FabianH2301/Studienarbeit/Platine/Studienarbeit.kicad_pcb

## KiCad design Platine/Studienarbeit.kicad_pcb (2020-02-13)

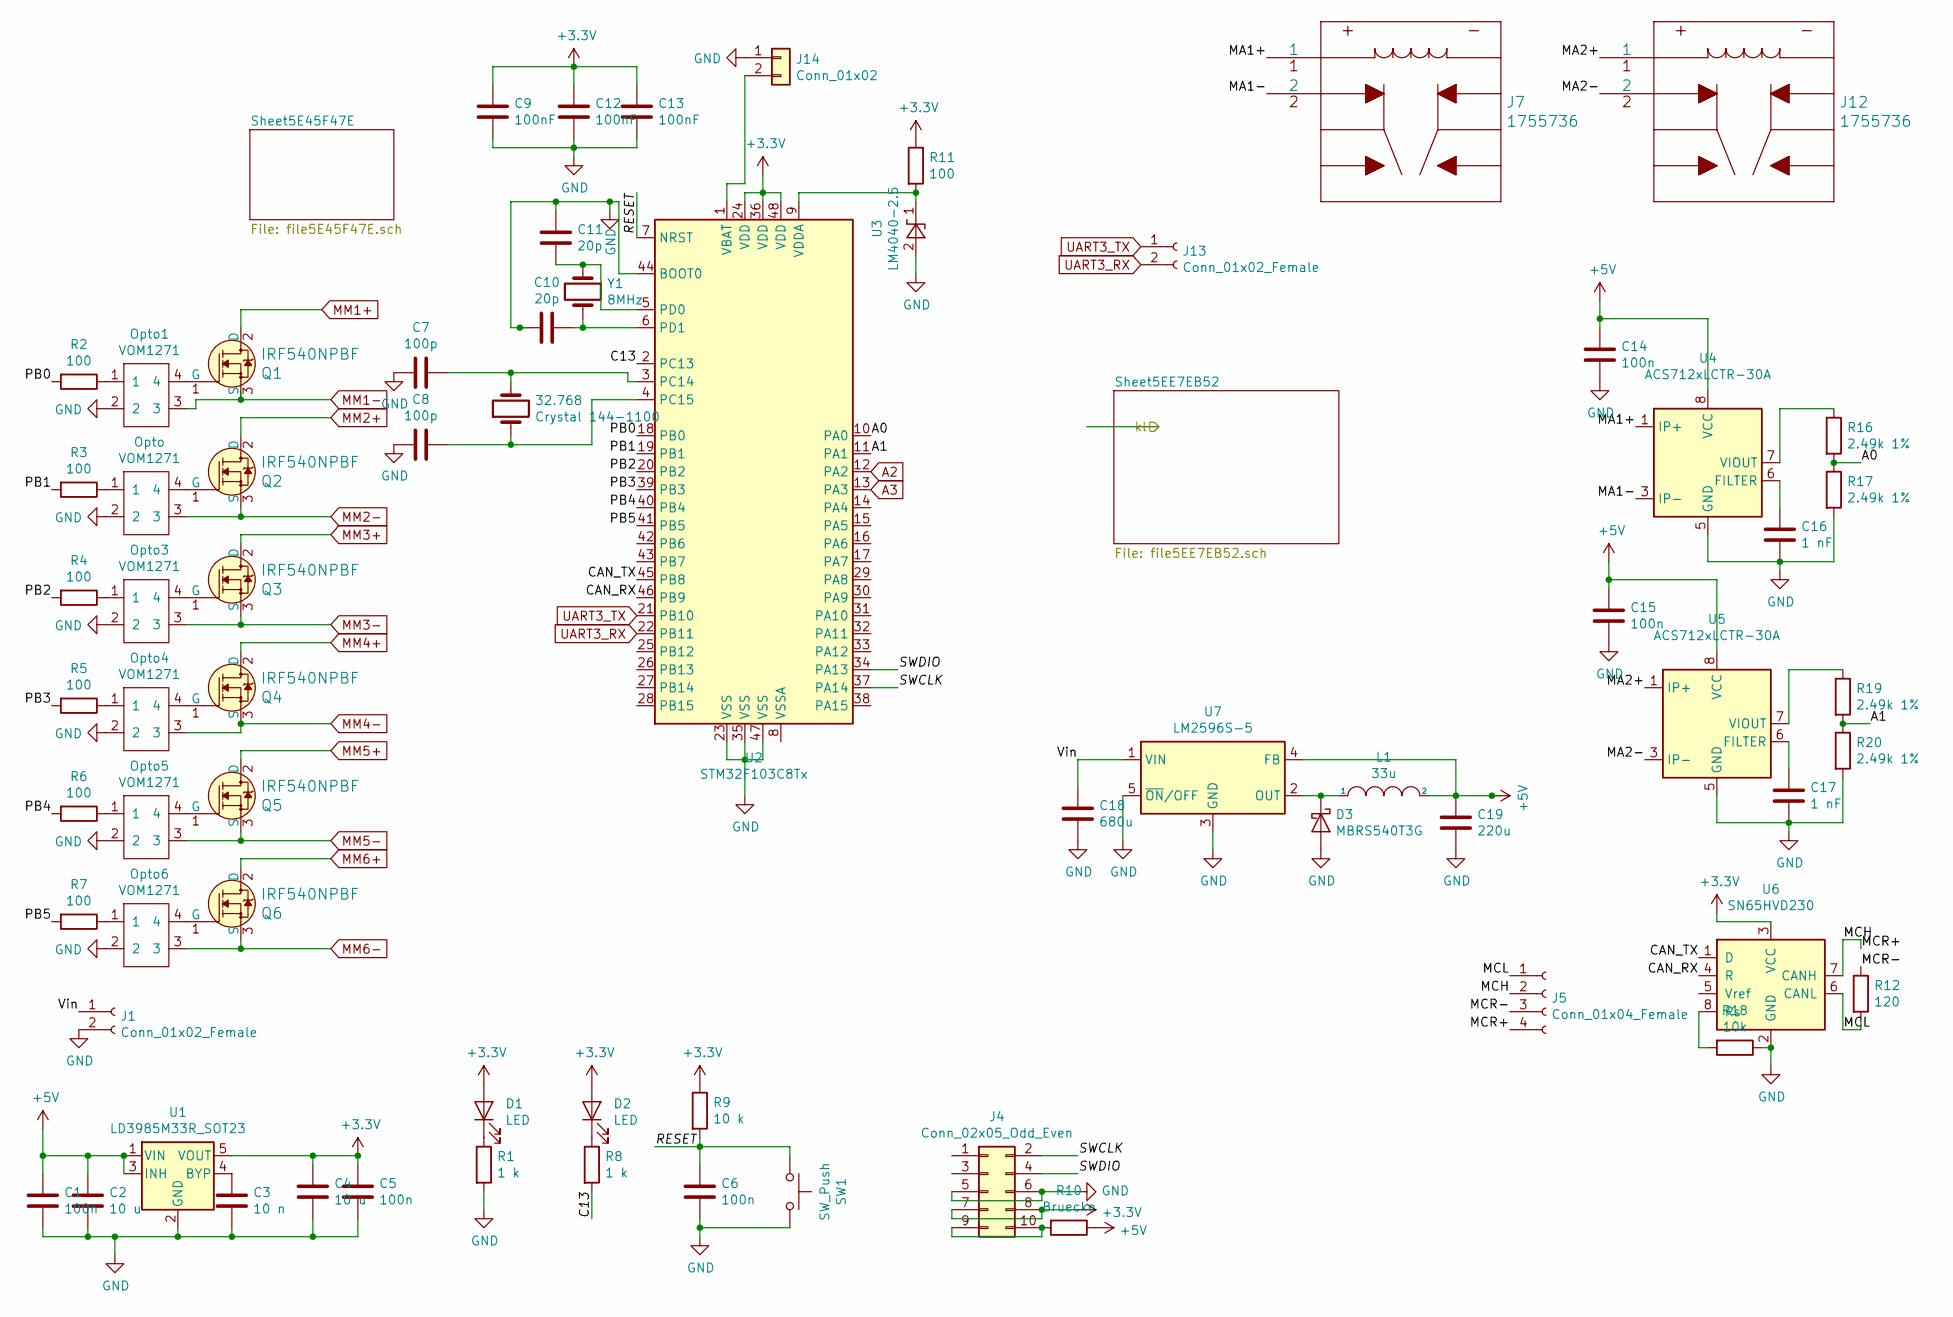
[picture p1: schematic Studienarbeit.sch]

Parts:
32.768: Crystal 144-1100; Crystal_SMD_2520-4Pin_2.5x2.0mm
C1, C5, C14, C15: 100n; C_0805_2012Metric; LCSC C136621
C2, C4: 10 u; C_0805_2012Metric; LCSC C15850
C3: 10 n; C_0805_2012Metric
C6: 100n; C_0805_2012Metric
C7, C8: 100p; C_0805_2012Metric
C9, C12, C13: 100nF; C_0805_2012Metric; LCSC C136621
C10, C11: 20p; C_0805_2012Metric
C16, C17: 1 nF; C_0805_2012Metric
C18: 680u; C_Elec_10x10.2
C19: 220u; C_Elec_8x6.2
D1, D2: LED; LED_0603_1608Metric; LCSC C2286
D3: MBRS540T3G; D_SMC; LCSC C31849
J1, J13: Conn_01x02_Female; JST_XH_B2B-XH-A_1x02_P2.50mm_Vertical
J4: Conn_02x05_Odd_Even; PinHeader_2x05_P2.54mm_Vertical
J5: Conn_01x04_Female; JST_XH_B4B-XH-A_1x04_P2.50mm_Vertical
J7, J12: 1755736; PhoenixContact1755736
J14: Conn_01x02; PinHeader_1x02_P2.54mm_Vertical
L1: 33u; L_Wuerth_WE-PD-Typ-LS
Opto, Opto1, Opto3, Opto4, Opto5, Opto6: VOM1271; LCSC C146286
Q1, Q2, Q3, Q4, Q5, Q6: IRF540NPBF; TO-220-3_Vertical; MPN IRF540NPBF; Digi-Key_PN IRF540NPBF-ND
R1, R8: 1 k; R_0805_2012Metric; LCSC C17513
R2: 100; R_0805_2012Metric
R3, R4, R5, R6, R7, R11: 100; R_0805_2012Metric; LCSC C17408
R9: 10 k; R_0805_2012Metric; LCSC C17414
R10: Bruecke; R_0805_2012Metric
R12: 120; R_0805_2012Metric; LCSC C17437
R16, R17, R19, R20: 2.49k 1%; R_0805_2012Metric; LCSC C17408
R18: 10k; R_0805_2012Metric; LCSC C17414
SW1: SW_Push; SW_SPST_B3S-1000
U1: LD3985M33R_SOT23; SOT-23-5; LCSC C46243
U2: STM32F103C8Tx; LQFP-48_7x7mm_P0.5mm; LCSC C8734
U3: LM4040-2.5; SOT-23
U4, U5: ACS712xLCTR-30A; SOIC-8_3.9x4.9mm_P1.27mm; LCSC C9932
U6: SN65HVD230; SOIC-8_3.9x4.9mm_P1.27mm; LCSC C12084
U7: LM2596S-5; TO-263-5_TabPin3; LCSC C10002
Y1: 8MHz; Crystal_HC49-4H_Vertical

Connections:
+3V3: C4.1, C5.1, C9.1, C12.1, C13.1, D1.2 (A), D2.2 (A), J4.7, J4.8, R9.1, R11.1, U1.5 (VOUT), U2.24 (VDD), U2.36 (VDD), U2.48 (VDD), U6.3 (VCC)
+5V: C1.1, C2.1, C14.2, C15.2, C19.1, L1.2, R10.1, U1.1 (VIN), U1.3 (INH), U4.8 (VCC), U5.8 (VCC), U7.4 (FB); also elsewhere on the board
/A0: R16.2, R17.1, U2.10 (PA0)
/A1: R19.2, R20.1, U2.11 (PA1)
/C13: R8.2, U2.2 (PC13)
/CAN_RX: U2.46 (PB9), U6.4 (R)
/CAN_TX: U2.45 (PB8), U6.1 (D)
/MA1+: J7.1, U4.1 (IP+), U4.2 (IP+)
/MA1-: J7.2, U4.3 (IP-), U4.4 (IP-)
/MA2+: J12.1, U5.1 (IP+), U5.2 (IP+)
/MA2-: J12.2, U5.3 (IP-), U5.4 (IP-)
/MCH: J5.2, J5.4, U6.7 (CANH)
/MCL: J5.1, R12.2, U6.6 (CANL)
/MCR-: J5.3, R12.1
/PB0: R2.2, U2.18 (PB0)
/PB1: R3.2, U2.19 (PB1)
/PB2: R4.2, U2.20 (PB2)
/PB3: R5.2, U2.39 (PB3)
/PB4: R6.2, U2.40 (PB4)
/PB5: R7.2, U2.41 (PB5)
/RESET: C6.1, R9.2, SW1.1, U2.7 (NRST)
/SWCLK: J4.2, U2.37 (PA14)
/SWDIO: J4.4, U2.34 (PA13)
/Vin: C18.1, J1.1, U7.1 (VIN)
A2: U2.12 (PA2); also elsewhere on the board
A3: U2.13 (PA3); also elsewhere on the board
GND: C1.2, C2.2, C3.2, C4.2, C5.2, C6.2, C7.2, C8.2, C9.2, C10.1, C11.1, C12.2, C13.2, C14.1, C15.1, C16.1, C17.1, C18.2, C19.2, D3.2 (A), J1.2, J4.5, J4.6, J14.1, Opto.2, Opto1.2, Opto3.2, Opto4.2, Opto5.2, Opto6.2, R1.2, R17.2, R18.1, R20.2, SW1.2, U1.2 (GND), U2.23 (VSS), U2.35 (VSS), U2.44 (BOOT0), U2.47 (VSS), U3.2 (A), U4.5 (GND), U5.5 (GND), U6.2 (GND), U7.3 (GND), U7.5 (~ON~/OFF); also elsewhere on the board
MM1+: Q1.2 (D); also elsewhere on the board
MM1-: Opto1.3, Q1.3 (S); also elsewhere on the board
MM2+: Q2.2 (D); also elsewhere on the board
MM2-: Opto.3, Q2.3 (S); also elsewhere on the board
MM3+: Q3.2 (D); also elsewhere on the board
MM3-: Opto3.3, Q3.3 (S); also elsewhere on the board
MM4+: Q4.2 (D); also elsewhere on the board
MM4-: Opto4.3, Q4.3 (S); also elsewhere on the board
MM5+: Q5.2 (D); also elsewhere on the board
MM5-: Opto5.3, Q5.3 (S); also elsewhere on the board
MM6+: Q6.2 (D); also elsewhere on the board
MM6-: Opto6.3, Q6.3 (S); also elsewhere on the board
unnamed: 32.768.1, C8.1, U2.4 (PC15)
unnamed: 32.768.2, C7.1, U2.3 (PC14)
unnamed: C3.1, U1.4 (BYP)
unnamed: C10.2, U2.6 (PD1), Y1.2
unnamed: C11.2, U2.5 (PD0), Y1.1
unnamed: C16.2, U4.6 (FILTER)
unnamed: C17.2, U5.6 (FILTER)
unnamed: D1.1 (K), R1.1
unnamed: D2.1 (K), R8.1
unnamed: D3.1 (K), L1.1, U7.2 (OUT)
unnamed: J4.9, J4.10, R10.2
unnamed: J14.2, U2.1 (VBAT)
unnamed: Opto1.1, R2.1
unnamed: Opto1.4, Q1.1 (G)
unnamed 72: Opto.1, R3.1; also elsewhere on the board
unnamed 73: Opto.4, Q2.1 (G); also elsewhere on the board
unnamed: Opto3.1, R4.1
unnamed: Opto3.4, Q3.1 (G)
unnamed: Opto4.1, R5.1
unnamed: Opto4.4, Q4.1 (G)
unnamed: Opto5.1, R6.1
unnamed: Opto5.4, Q5.1 (G)
unnamed: Opto6.1, R7.1
unnamed: Opto6.4, Q6.1 (G)
unnamed: R11.2, U2.9 (VDDA), U3.1 (K)
unnamed: R16.1, U4.7 (VIOUT)
unnamed: R18.2, U6.8 (Rs)
unnamed: R19.1, U5.7 (VIOUT)
UART3_RX: J13.2, U2.22 (PB11)
UART3_TX: J13.1, U2.21 (PB10)

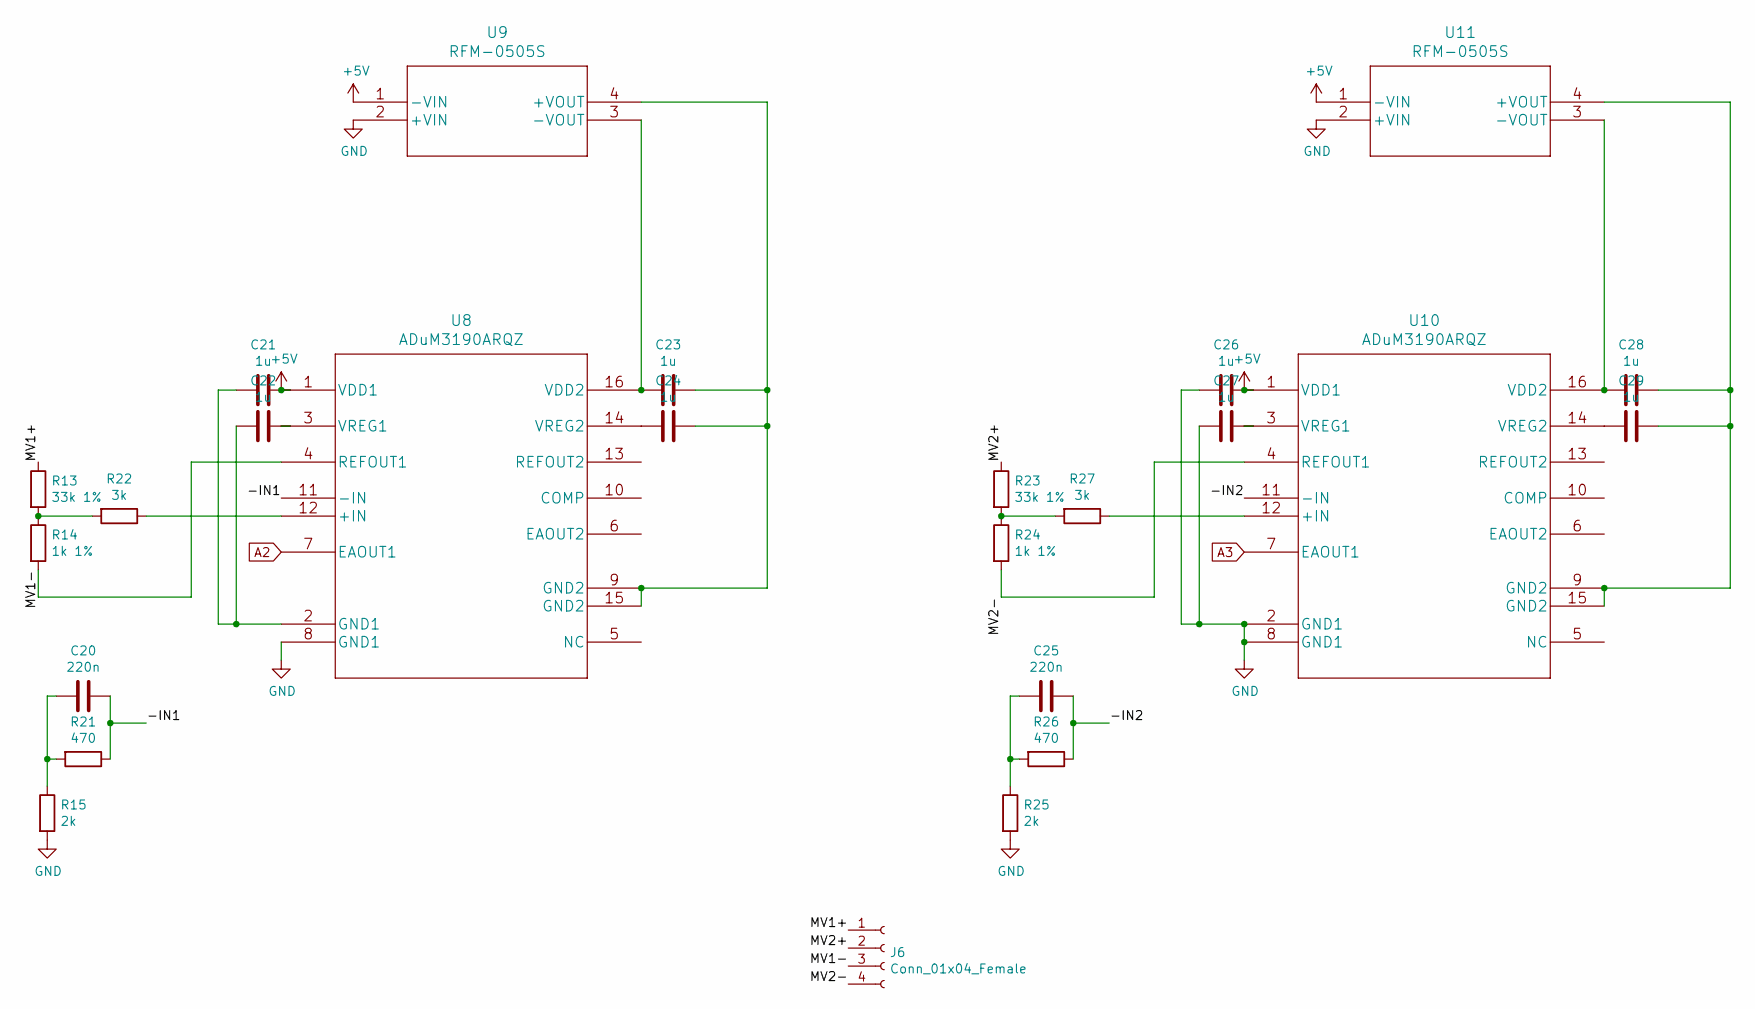
[picture p2: schematic file5EE7EB52.sch]

Parts:
C20, C25: 220n; C_0805_2012Metric; LCSC C5378
C21, C22, C23, C24, C26, C27, C28, C29: 1u; C_0805_2012Metric; LCSC C28323
J6: Conn_01x04_Female; JST_XH_B4B-XH-A_1x04_P2.50mm_Vertical
R13, R23: 33k 1%; R_0805_2012Metric; LCSC C17633
R14, R24: 1k 1%; R_0805_2012Metric; LCSC C17513
R15, R25: 2k; R_0805_2012Metric; LCSC C17604
R21, R26: 470; R_0805_2012Metric; LCSC C17710
R22, R27: 3k; R_0805_2012Metric; LCSC C17661
U8, U10: ADuM3190ARQZ
U9, U11: RFM-0505S

Connections:
+5V: C21.2, C26.2, U8.1 (VDD1), U9.1 (-VIN), U10.1 (VDD1), U11.1 (-VIN); also elsewhere on the board
/Sheet5EE7EB52/-IN1: C20.1, R21.1, U8.11 (-IN)
/Sheet5EE7EB52/-IN2: C25.1, R26.1, U10.11 (-IN)
/Sheet5EE7EB52/MV1+: J6.1, R13.1
/Sheet5EE7EB52/MV1-: J6.3, R14.2, U8.4 (REFOUT1)
/Sheet5EE7EB52/MV2+: J6.2, R23.1
/Sheet5EE7EB52/MV2-: J6.4, R24.2, U10.4 (REFOUT1)
A2: U8.7 (EAOUT1); also elsewhere on the board
A3: U10.7 (EAOUT1); also elsewhere on the board
GND: C26.1, C27.1, R15.2, R25.2, U8.8 (GND1), U9.2 (+VIN), U10.2 (GND1), U10.8 (GND1), U11.2 (+VIN); also elsewhere on the board
unnamed: C20.2, R15.1, R21.2
unnamed: C21.1, C22.1, U8.2 (GND1)
unnamed: C22.2, U8.3 (VREG1)
unnamed: C23.1, U8.16 (VDD2), U9.3 (-VOUT)
unnamed: C23.2, C24.2, U8.9 (GND2), U8.15 (GND2), U9.4 (+VOUT)
unnamed: C24.1, U8.14 (VREG2)
unnamed: C25.2, R25.1, R26.2
unnamed: C27.2, U10.3 (VREG1)
unnamed: C28.1, U10.16 (VDD2), U11.3 (-VOUT)
unnamed: C28.2, C29.2, U10.9 (GND2), U10.15 (GND2), U11.4 (+VOUT)
unnamed: C29.1, U10.14 (VREG2)
unnamed: R13.2, R14.1, R22.2
unnamed: R22.1, U8.12 (+IN)
unnamed: R23.2, R24.1, R27.2
unnamed: R27.1, U10.12 (+IN)

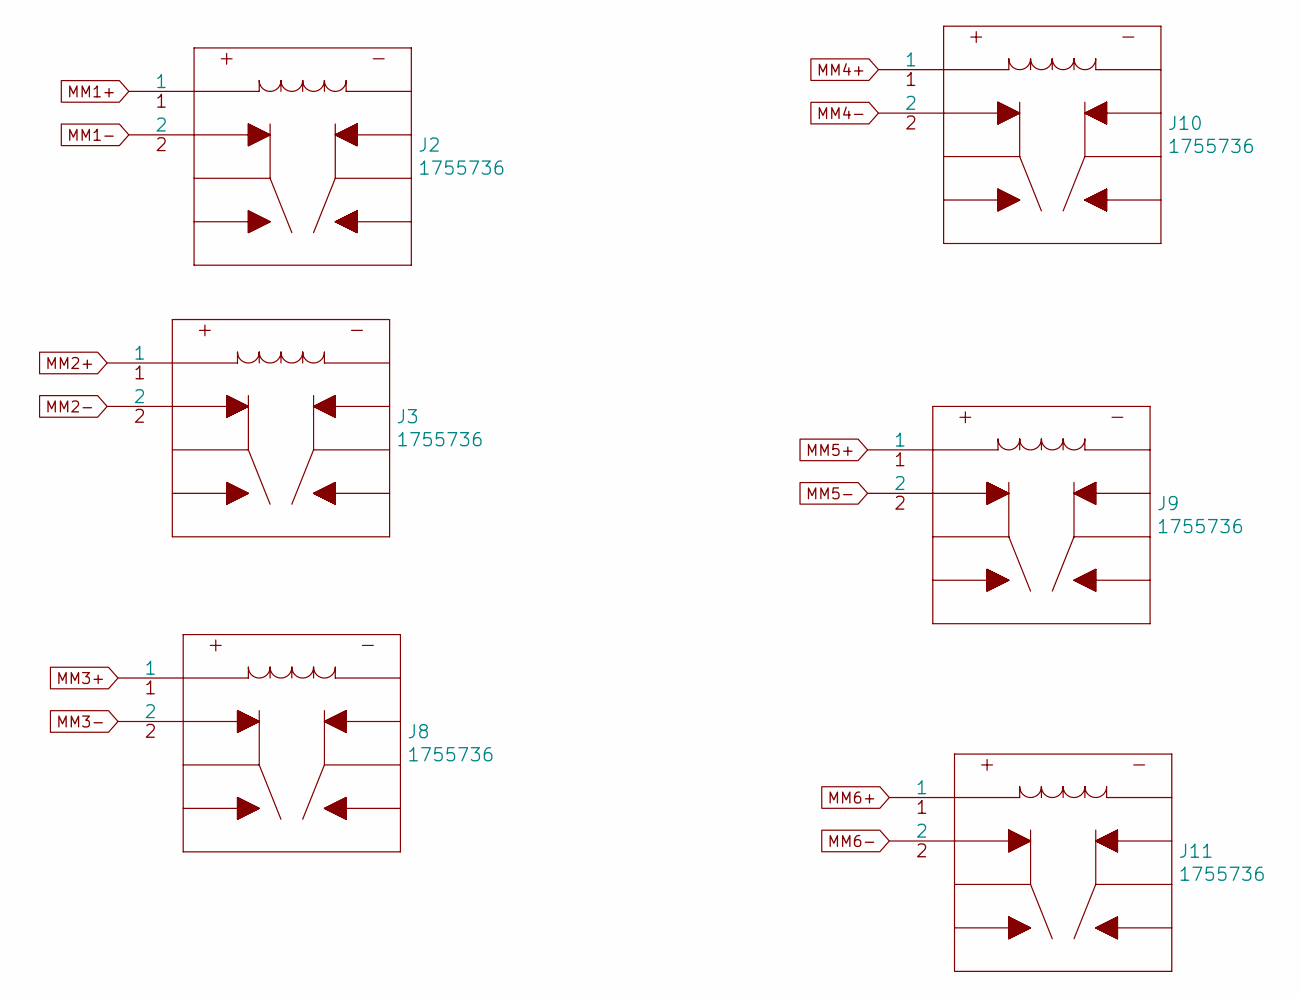
[picture p3: schematic file5E45F47E.sch]

Parts:
J2, J3, J8, J9, J10, J11: 1755736; PhoenixContact1755736

Connections:
MM1+: J2.1; also elsewhere on the board
MM1-: J2.2; also elsewhere on the board
MM2+: J3.1; also elsewhere on the board
MM2-: J3.2; also elsewhere on the board
MM3+: J8.1; also elsewhere on the board
MM3-: J8.2; also elsewhere on the board
MM4+: J10.1; also elsewhere on the board
MM4-: J10.2; also elsewhere on the board
MM5+: J9.1; also elsewhere on the board
MM5-: J9.2; also elsewhere on the board
MM6+: J11.1; also elsewhere on the board
MM6-: J11.2; also elsewhere on the board

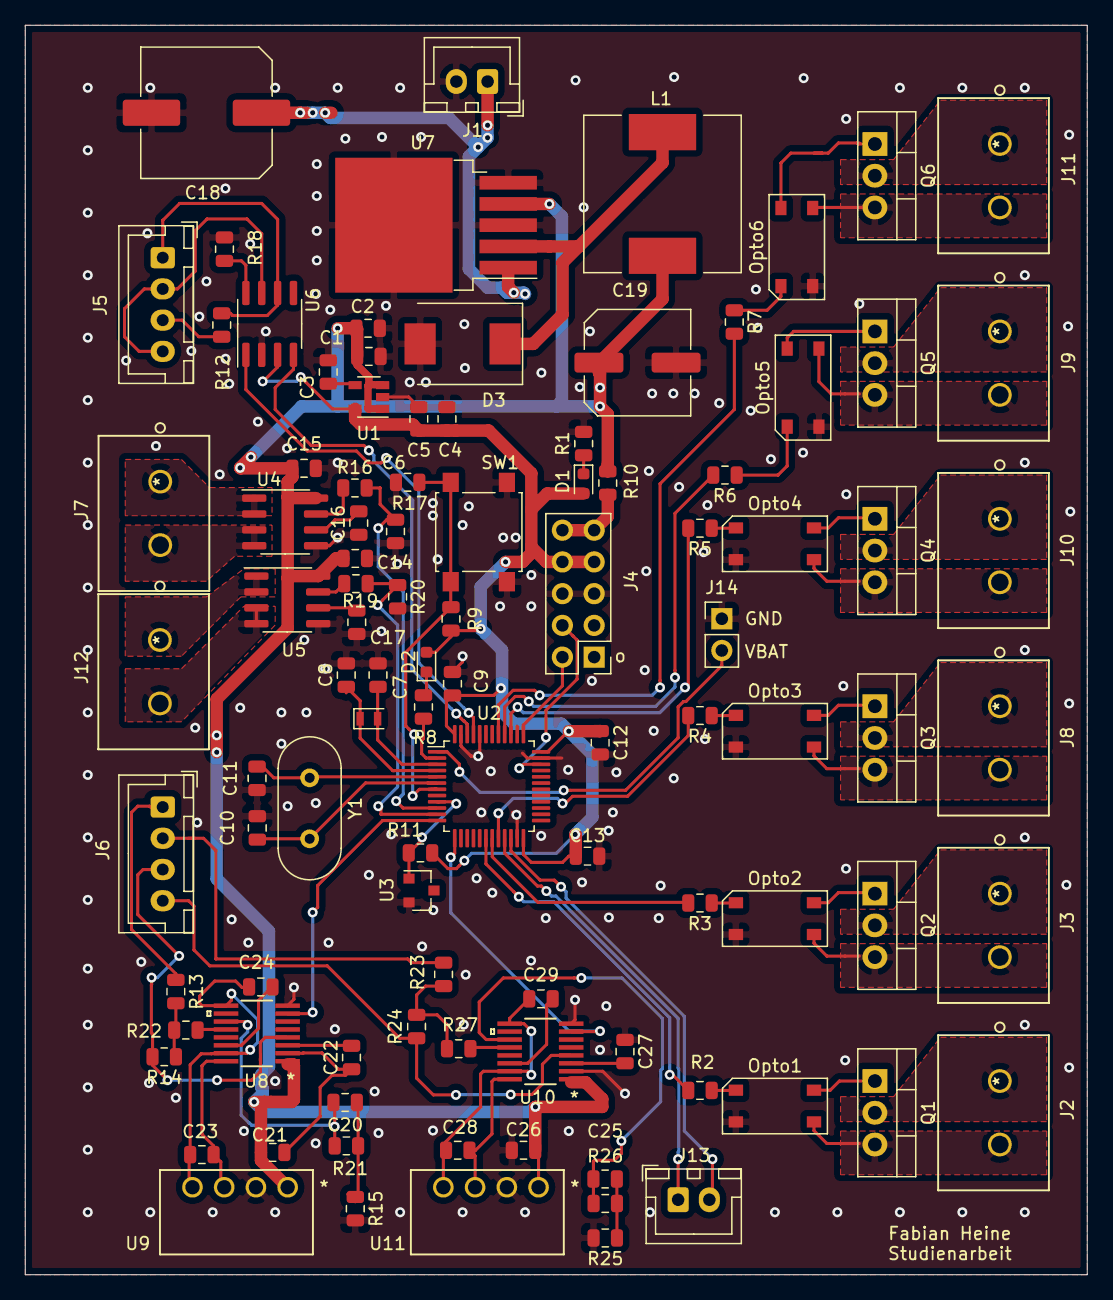
[picture p4: board Studienarbeit.kicad_pcb from above]

Board: 2 copper layers, 85.0 x 100.0 mm, 100 parts (0 on the bottom side), 90 nets.

Other parts of the board:
Opto2: VOM1271

Their connections:
GND: Opto2.2; also elsewhere on the board
MM2-: Opto2.3; also elsewhere on the board
unnamed 72: Opto2.1; also elsewhere on the board
unnamed 73: Opto2.4; also elsewhere on the board
