FabianH2301/Studienarbeit/(commit log)

2020-02-04 Initial SetUp
    [blink_test Debug.cfg]
2020-02-04 KICAD Dateien
    [Studienarbeit.kicad_pcb, Studienarbeit.sch]
2020-02-04 Initial Ordnerstruktur
    [Studienarbeit.kicad_pcb, Studienarbeit.sch, blink_test Debug.cfg]
2020-02-04 To much for description
    [STM32.kicad_pcb, STM32.sch, Studienarbeit.sch, Studienarbeit_STM32 Debug.cfg]
2020-02-10 To much to detect
    [Studienarbeit.kicad_pcb, Studienarbeit.sch]
2020-02-10 Platine fertig geroutet
    ToDO:
    5mm Leiterbahnbreite anpassen
    GND Verbindungen vollständig herstellen
    Kondensatoren prüfen SMD!!
    [Studienarbeit.kicad_pcb]
2020-02-13 platine final ready to order
    [Studienarbeit (2).csv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]
2020-02-13 Platine fertig
    [Studienarbeit-B_Cu.gbr, Studienarbeit-B_Mask.gbr, Studienarbeit-Edge_Cuts.gbr, Studienarbeit-F_Cu.gbr, Studienarbeit-F_Mask.gbr, Studienarbeit-F_SilkS.gbr, Studienarbeit-NPTH.drl, Studienarbeit-PTH.drl]
